Miky8745/HalfLife-Drone/frame/drone-framev1.FCStd

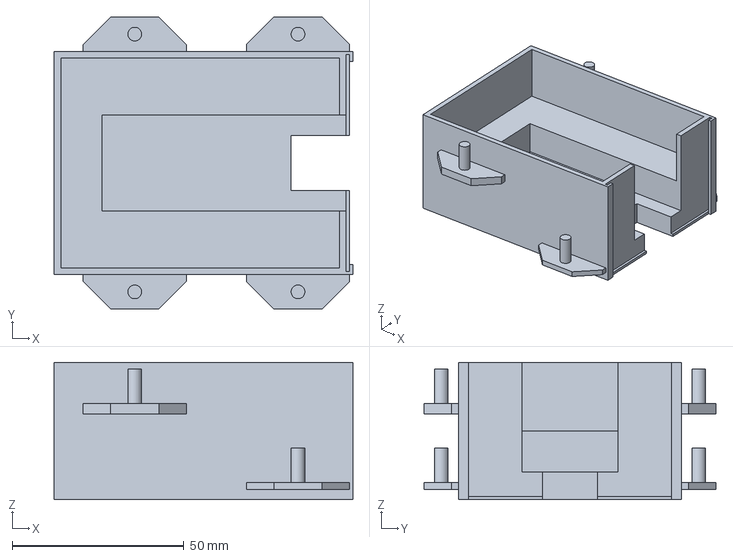
[picture p3: CAD file, 2026-10-18]
frame/drone-framev1.FCStd
87.0 x 85.0 x 40.0 mm
