Miky8745/HalfLife-Drone/frame/freecad_demo/part5.FCStd

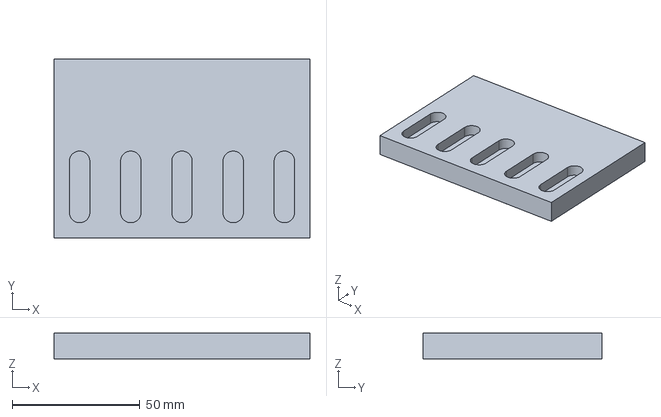
[picture p4: CAD file, 2026-10-12]
frame/freecad_demo/part5.FCStd
100.0 x 70.0 x 10.0 mm
