Miky8745/HalfLife-Drone/frame/step/drone-framev2.step

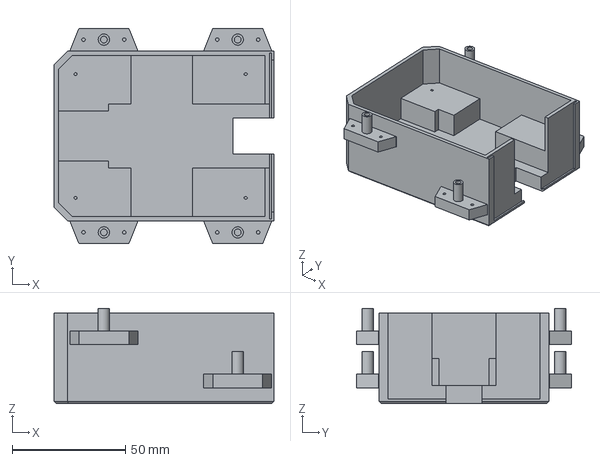
[picture p5: CAD file, 2026-11-12]
frame/step/drone-framev2.step
97.0 x 95.0 x 42.0 mm
