Miky8745/HalfLife-Drone/frame/freecad_demo/part7.FCStd

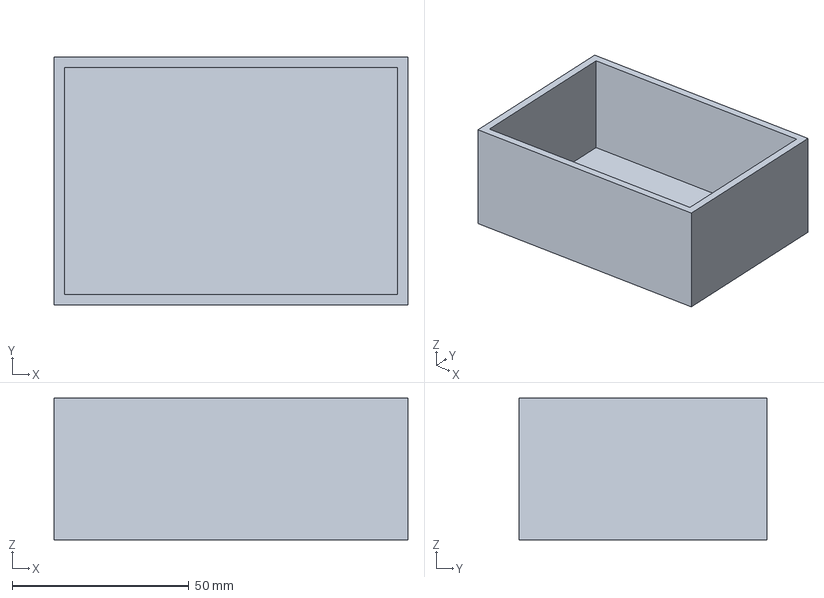
[picture p6: CAD file, 2026-10-12]
frame/freecad_demo/part7.FCStd
100.0 x 70.0 x 40.0 mm
