Miky8745/HalfLife-Drone/frame/step/backplate.step

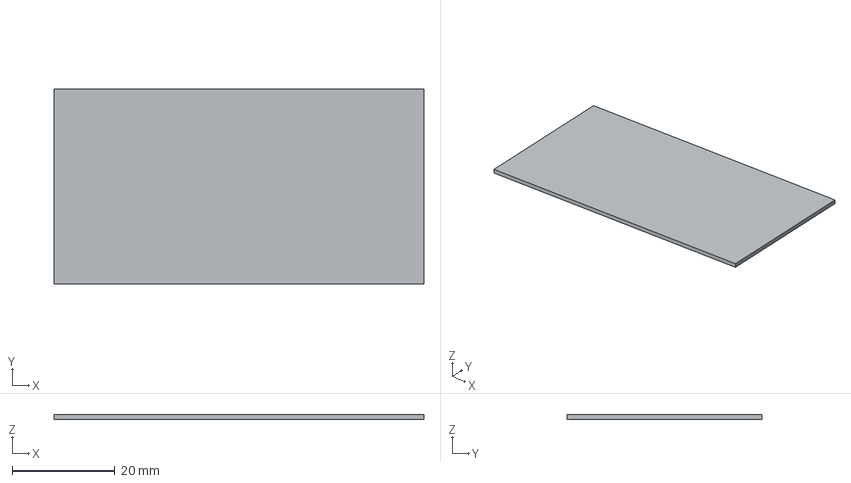
[picture p7: CAD file, 2026-11-12]
frame/step/backplate.step
72.0 x 38.0 x 1.00 mm
