Miky8745/HalfLife-Drone/frame/freecad_demo/part2.FCStd

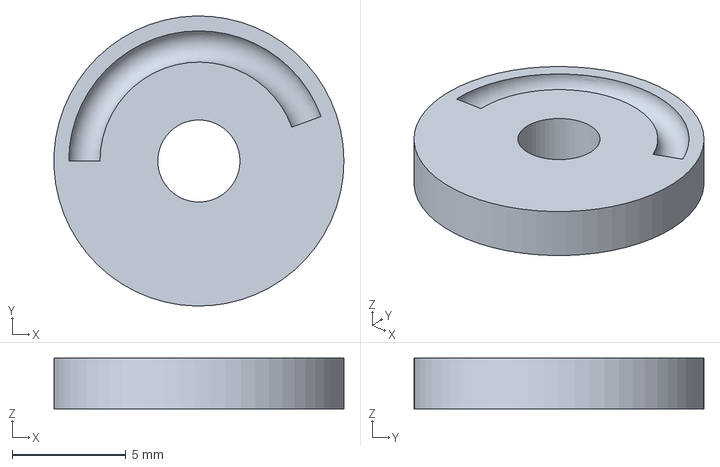
[picture p8: CAD file, 2026-10-12]
frame/freecad_demo/part2.FCStd
12.8 x 12.8 x 2.24 mm
