Miky8745/HalfLife-Drone/frame/step/prop_holder_a.step

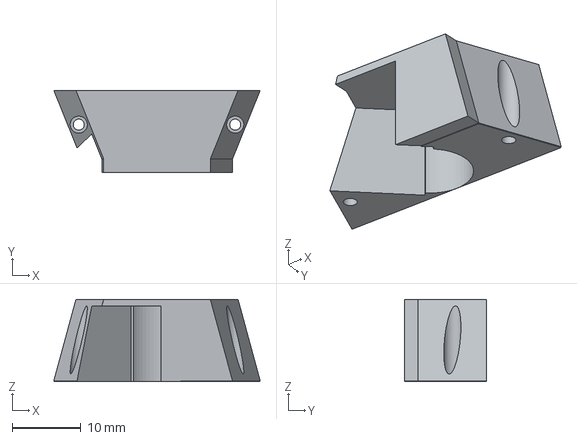
[picture p9: CAD file, 2026-11-12]
frame/step/prop_holder_a.step
30.0 x 12.0 x 12.0 mm
