Miky8745/HalfLife-Drone/frame/freecad_demo/part1.FCStd

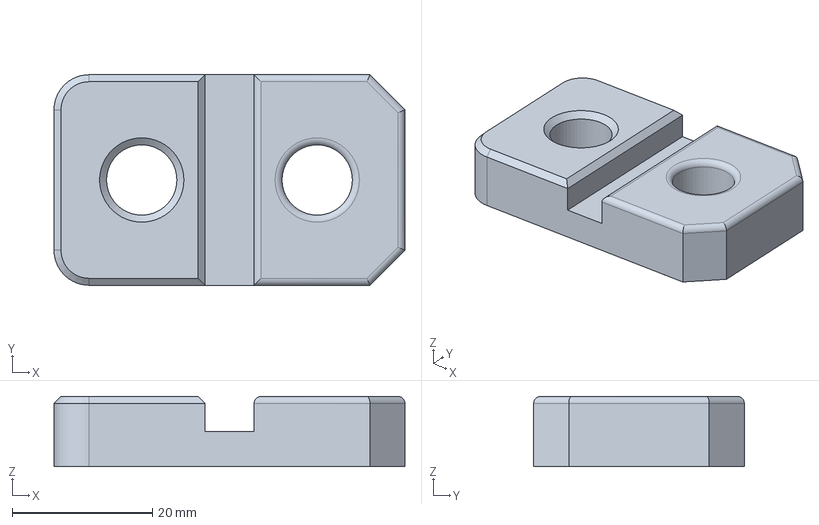
[picture p10: CAD file, 2026-10-12]
frame/freecad_demo/part1.FCStd
50.0 x 30.0 x 10.0 mm
