Miky8745/HalfLife-Drone/frame/step/roof.step

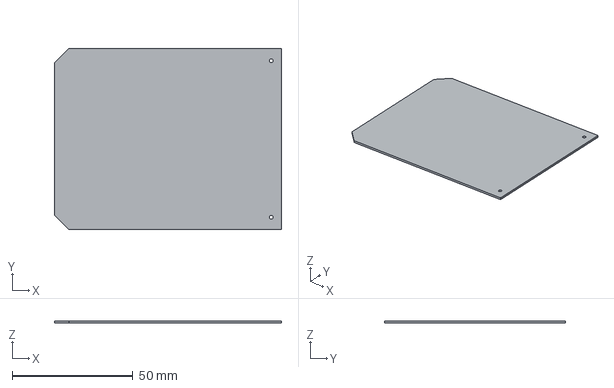
[picture p11: CAD file, 2026-11-12]
frame/step/roof.step
94.0 x 75.0 x 1.00 mm
