Miky8745/HalfLife-Drone/frame/freecad_demo/part6.FCStd

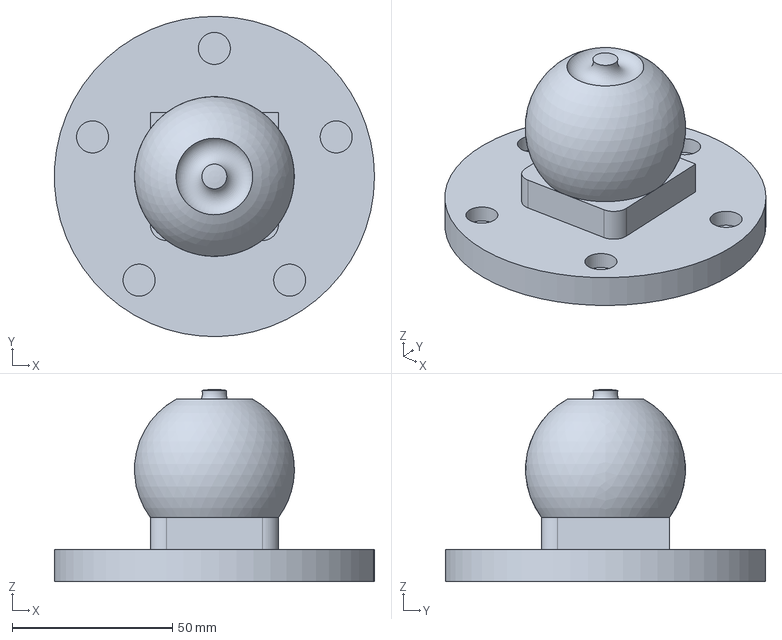
[picture p12: CAD file, 2026-10-12]
frame/freecad_demo/part6.FCStd
99.9 x 100.0 x 60.0 mm
