Miky8745/HalfLife-Drone/frame/freecad_demo/part3.FCStd

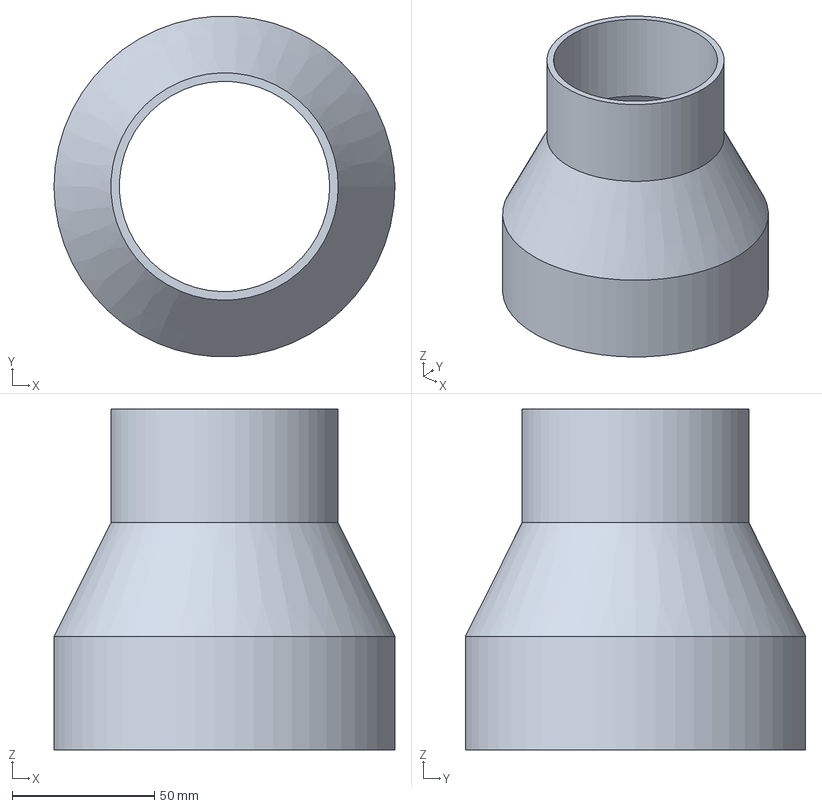
[picture p13: CAD file, 2026-10-12]
frame/freecad_demo/part3.FCStd
120.0 x 119.8 x 120.0 mm
