Miky8745/HalfLife-Drone/frame/step/pcb_holder.step

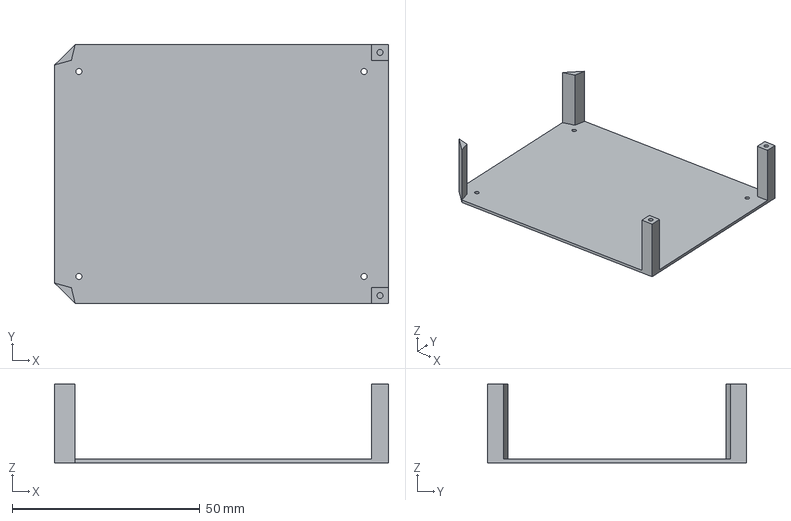
[picture p14: CAD file, 2026-11-12]
frame/step/pcb_holder.step
89.0 x 69.0 x 21.0 mm
