Miky8745/HalfLife-Drone/frame/freecad_demo/part4.FCStd

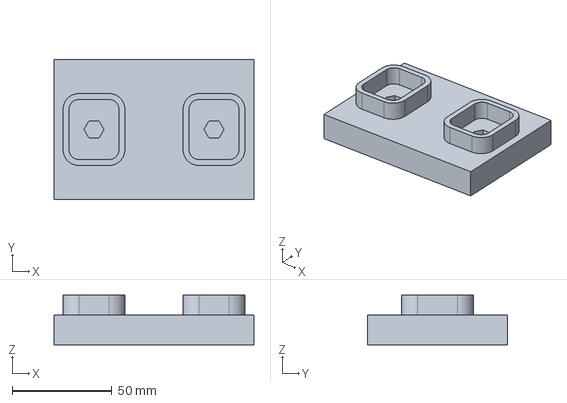
[picture p15: CAD file, 2026-10-12]
frame/freecad_demo/part4.FCStd
100.0 x 70.0 x 25.0 mm
