Miky8745/HalfLife-Drone/(list of files, cad)

Other CAD files:
frame/stl/drone-frame.stl
frame/step/prop_holder_b.step
frame/backplate.FCStd
frame/drone-framev2.FCStd
frame/pcb_holder.FCStd
frame/prop_holder_a.FCStd
frame/prop_holder_b.FCStd
frame/roof.FCStd
frame/stl/backplate.stl
frame/stl/pcb-holder.stl
frame/stl/prop_holder_a.stl
frame/stl/prop_holder_b.stl
frame/stl/roof.stl
