Miky8745/HalfLife-Drone/esp_extension/esp_extension.kicad_pcb

## KiCad design esp_extension/esp_extension.kicad_pcb (2026-10-11)

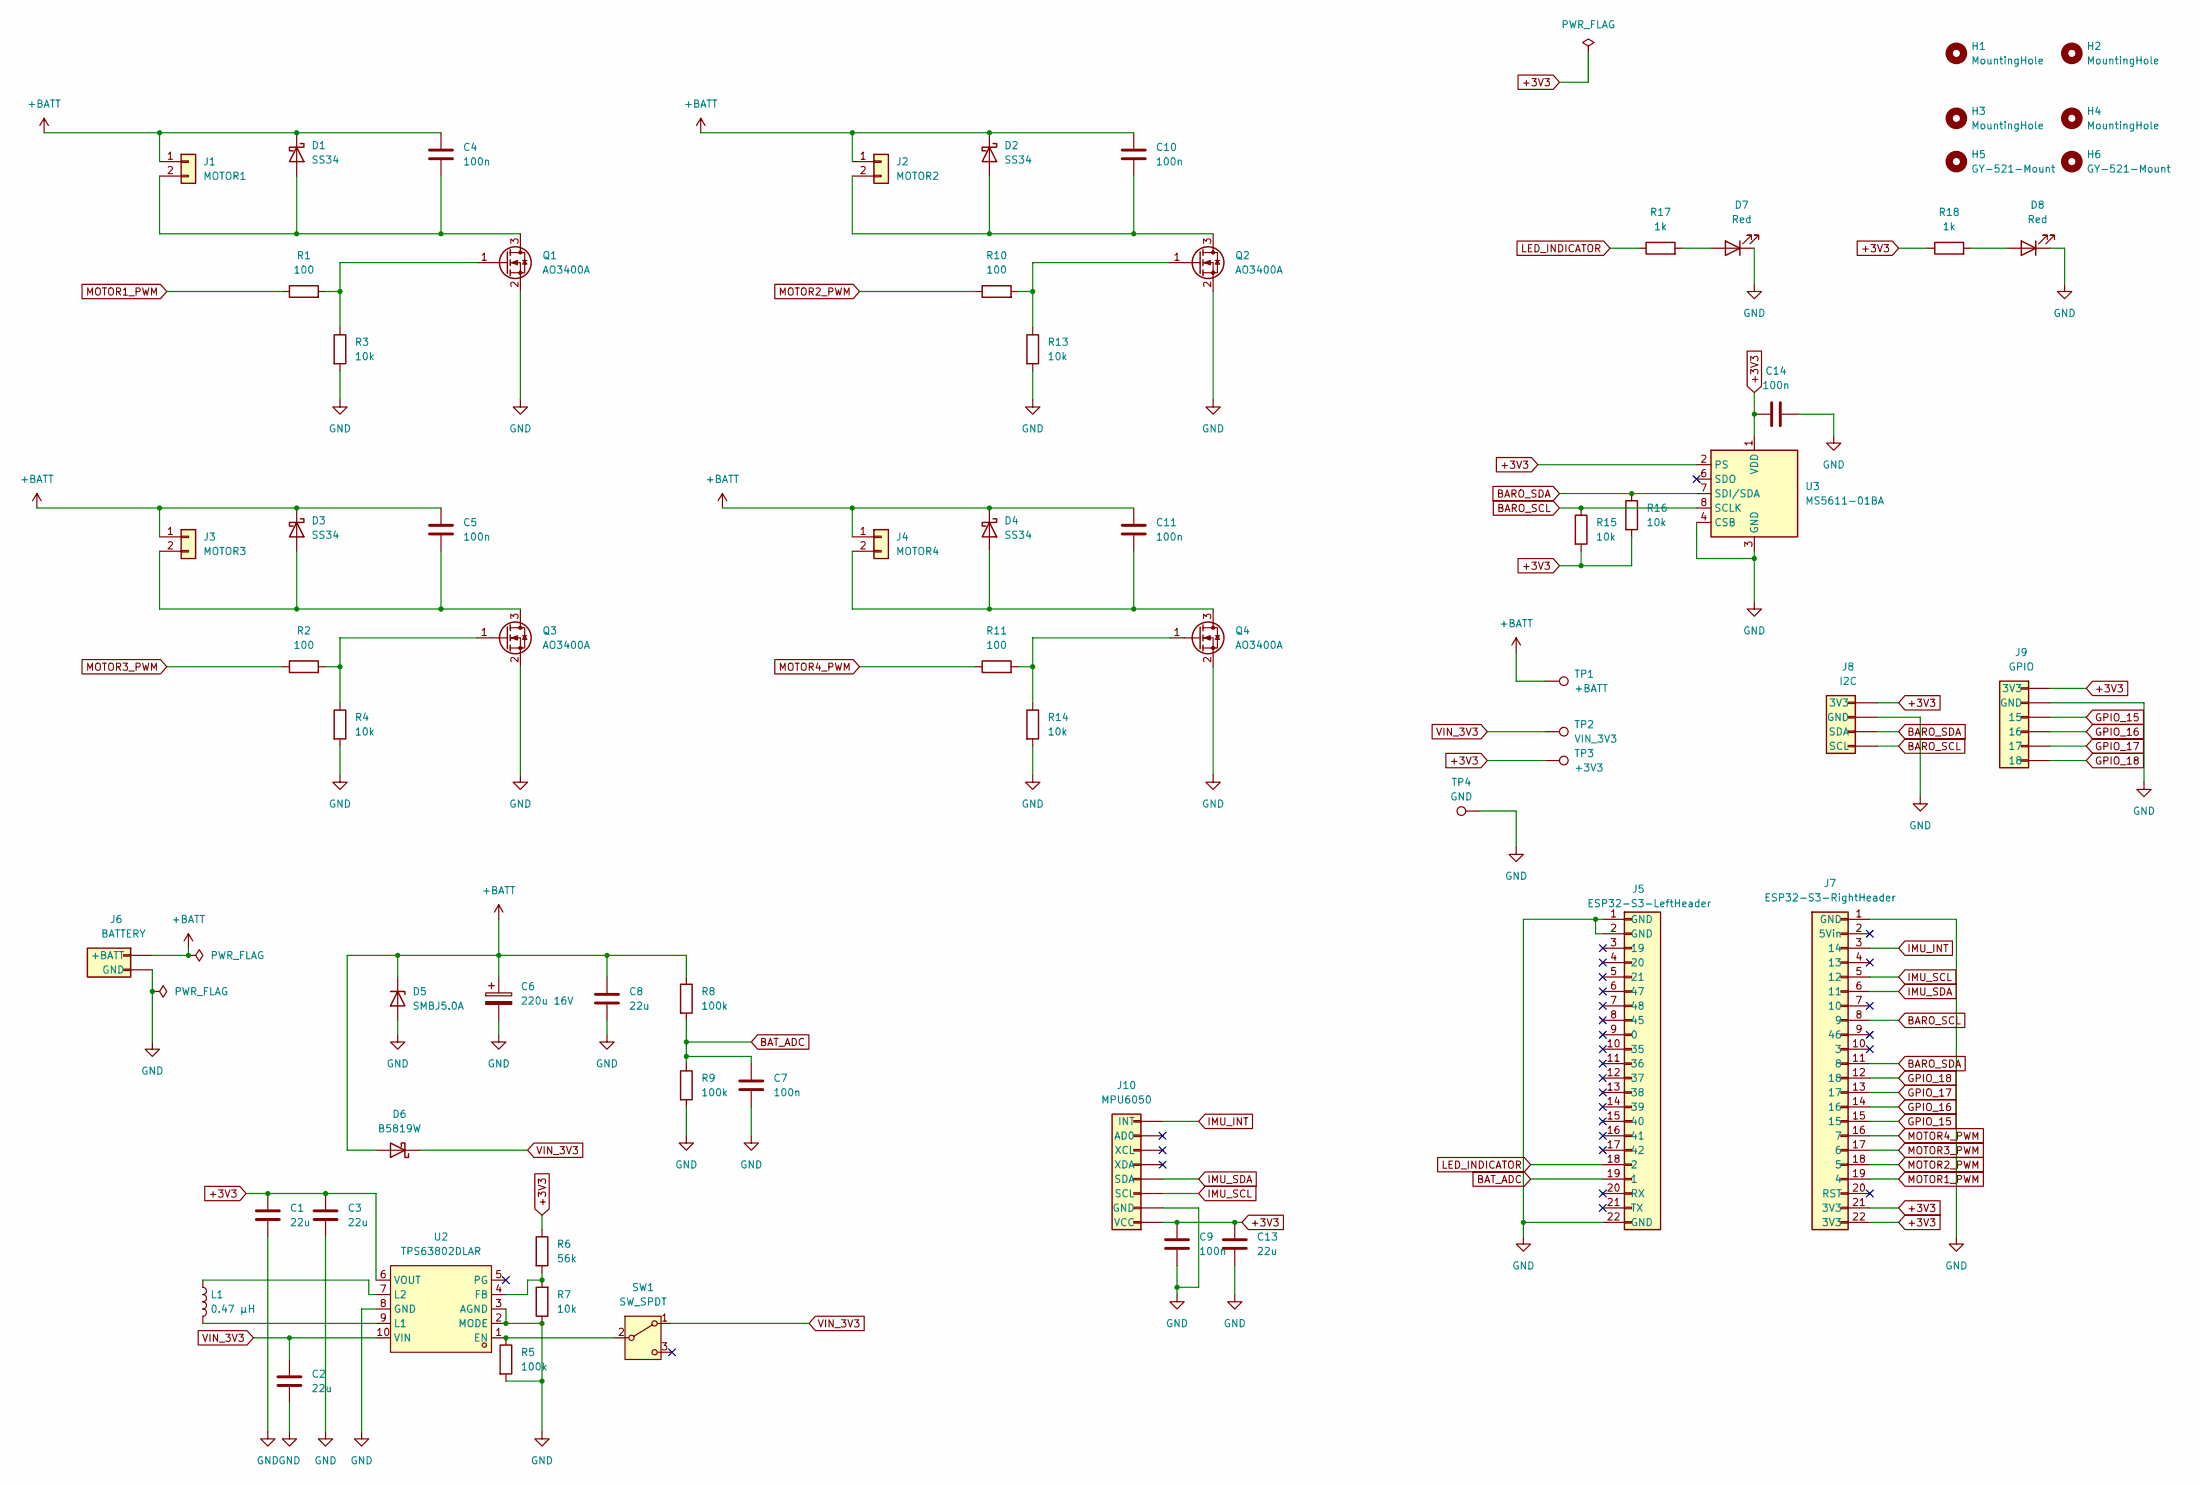
[picture p16: schematic esp_extension.kicad_sch, ESP32 Drone Motor Card]

Parts:
C1, C2, C3, C8, C13: 22u; C_0805_2012Metric; MPN CL21A226MAQNNNE; LCSC Part C45783
C4, C5, C7, C9, C10, C11, C14: 100n; C_0603_1608Metric; MPN CC0603KRX7R9BB104; LCSC Part C14663
C6: 220u 16V; CP_Radial_D6.3mm_P2.50mm; MPN TFR_220_16_85
D1, D2, D3, D4: SS34; D_SMA; MPN SS34; LCSC Part C8678
D5: SMBJ5.0A; D_SMB; MPN SMBJ5.0A; LCSC Part C19077558
D6: B5819W; D_SOD-123; MPN B5819W SL; LCSC Part C8598
D7, D8: Red; LED_0603_1608Metric; MPN KT-0603R; LCSC Part C2286
H1, H2, H3, H4: MountingHole; MountingHole_2.2mm_M2
H5, H6: GY-521-Mount; MountingHole_3.2mm_M3
J1: MOTOR1; SolderWire-0.25sqmm_1x02_P4.2mm_D0.65mm_OD1.7mm
J2: MOTOR2; SolderWire-0.25sqmm_1x02_P4.2mm_D0.65mm_OD1.7mm
J3: MOTOR3; SolderWire-0.25sqmm_1x02_P4.2mm_D0.65mm_OD1.7mm
J4: MOTOR4; SolderWire-0.25sqmm_1x02_P4.2mm_D0.65mm_OD1.7mm
J5: ESP32-S3-LeftHeader; PinSocket_1x22_P2.54mm_Vertical
J6: BATTERY; SolderWire-0.5sqmm_1x02_P4.8mm_D0.9mm_OD2.3mm
J7: ESP32-S3-RightHeader; PinSocket_1x22_P2.54mm_Vertical
J8: I2C; PinHeader_1x04_P2.54mm_Vertical
J9: GPIO; PinHeader_1x06_P2.54mm_Vertical
J10: MPU6050; PinSocket_1x08_P2.54mm_Vertical
L1: 0.47 µH; IND-SMD_L2.0-W1.6-1; MPN DFE201612E-R47M=P2; LCSC Part C668312
Q1, Q2, Q3, Q4: AO3400A; SOT-23; MPN AO3400A; LCSC Part C20917
R1, R2, R10, R11: 100; R_0603_1608Metric; MPN 0603WAF1000T5E; LCSC Part C22775
R3, R4, R7, R13, R14, R15, R16: 10k; R_0603_1608Metric; MPN 0603WAF1002T5E; LCSC Part C25804
R5, R8, R9: 100k; R_0603_1608Metric; MPN 0603WAF1003T5E; LCSC Part C25803
R6: 56k; R_0603_1608Metric; MPN 0603WAF5602T5E; LCSC Part C23206
R17, R18: 1k; R_0603_1608Metric; MPN 0603WAF1001T5E; LCSC Part C21190
SW1: SW_SPDT; PinHeader_1x03_P2.54mm_Vertical; MPN S103mini
TP1: +BATT; TestPoint_Pad_D1.5mm
TP2: VIN_3V3; TestPoint_Pad_D1.5mm
TP3: +3V3; TestPoint_Pad_D1.5mm
TP4: GND; TestPoint_Pad_D1.5mm
U2: TPS63802DLAR; VSON-10_L3.0-W2.0-P0.50-TL; MPN TPS63802DLAR; LCSC Part C2845237
U3: MS5611-01BA; LGA-8_3x5mm_P1.25mm; MPN MS561101BA03-50; LCSC Part C15639

Connections:
+3V3: C1.1, C3.1, C9.2, C13.1, C14.1, J7.21 (3V3), J7.22 (3V3), J8.1 (3V3), J9.1 (3V3), J10.1 (VCC), R6.1, R15.2, R16.2, R18.1, TP3.1 (1_1), U2.6 (VOUT), U3.1 (VDD), U3.2 (PS)
+BATT: C4.1, C5.1, C6.1, C8.1, C10.1, C11.1, D1.1 (K), D2.1 (K), D3.1 (K), D4.1 (K), D5.1 (K), D6.2 (A), J1.1, J2.1, J3.1, J4.1, J6.1 (+BATT), R8.1, TP1.1 (1_1)
BARO_SCL: J7.8 (9), J8.4 (SCL), R15.1, U3.8 (SCLK)
BARO_SDA: J7.11 (8), J8.3 (SDA), R16.1, U3.7 (SDI/SDA)
BAT_ADC: C7.1, J5.19 (1), R8.2, R9.1
GND: C1.2, C2.2, C3.2, C6.2, C7.2, C8.2, C9.1, C13.2, C14.2, D5.2 (A), D7.1 (K), D8.1 (K), J5.1 (GND), J5.2 (GND), J5.22 (GND), J6.2 (GND), J7.1 (GND), J8.2 (GND), J9.2 (GND), J10.2 (GND), Q1.2 (S), Q2.2 (S), Q3.2 (S), Q4.2 (S), R3.2, R4.2, R5.2, R7.1, R9.2, R13.2, R14.2, TP4.1 (1_1), U2.2 (MODE), U2.3 (AGND), U2.8 (GND), U3.3 (GND), U3.4 (CSB), U3.5 (CSB)
GPIO_15: J7.15, J9.3 (15)
GPIO_16: J7.14 (16), J9.4 (16)
GPIO_17: J7.13 (17), J9.5 (17)
GPIO_18: J7.12 (18), J9.6 (18)
IMU_INT: J7.3 (14), J10.8 (INT)
IMU_SCL: J7.5 (12), J10.3 (SCL)
IMU_SDA: J7.6 (11), J10.4 (SDA)
LED_INDICATOR: J5.18 (2), R17.1
MOTOR1_PWM: J7.19 (4), R1.1
MOTOR2_PWM: J7.18 (5), R10.1
MOTOR3_PWM: J7.17 (6), R2.1
MOTOR4_PWM: J7.16 (7), R11.1
unnamed: C4.2, D1.2 (A), J1.2, Q1.3 (D)
unnamed: C10.2, D2.2 (A), J2.2, Q2.3 (D)
unnamed: C5.2, D3.2 (A), J3.2, Q3.3 (D)
unnamed: C11.2, D4.2 (A), J4.2, Q4.3 (D)
unnamed: D7.2 (A), R17.2
unnamed: D8.2 (A), R18.2
unnamed: Q1.1 (G), R1.2, R3.1
unnamed: Q2.1 (G), R10.2, R13.1
unnamed: Q3.1 (G), R2.2, R4.1
unnamed: Q4.1 (G), R11.2, R14.1
unnamed: R5.1, SW1.2 (B), U2.1 (EN)
unnamed: R6.2, R7.2, U2.4 (FB)
unnamed: L1.2, U2.9 (L1)
unnamed: L1.1, U2.7 (L2)
VIN_3V3: C2.1, D6.1 (K), SW1.1 (A), TP2.1 (1_1), U2.10 (VIN)

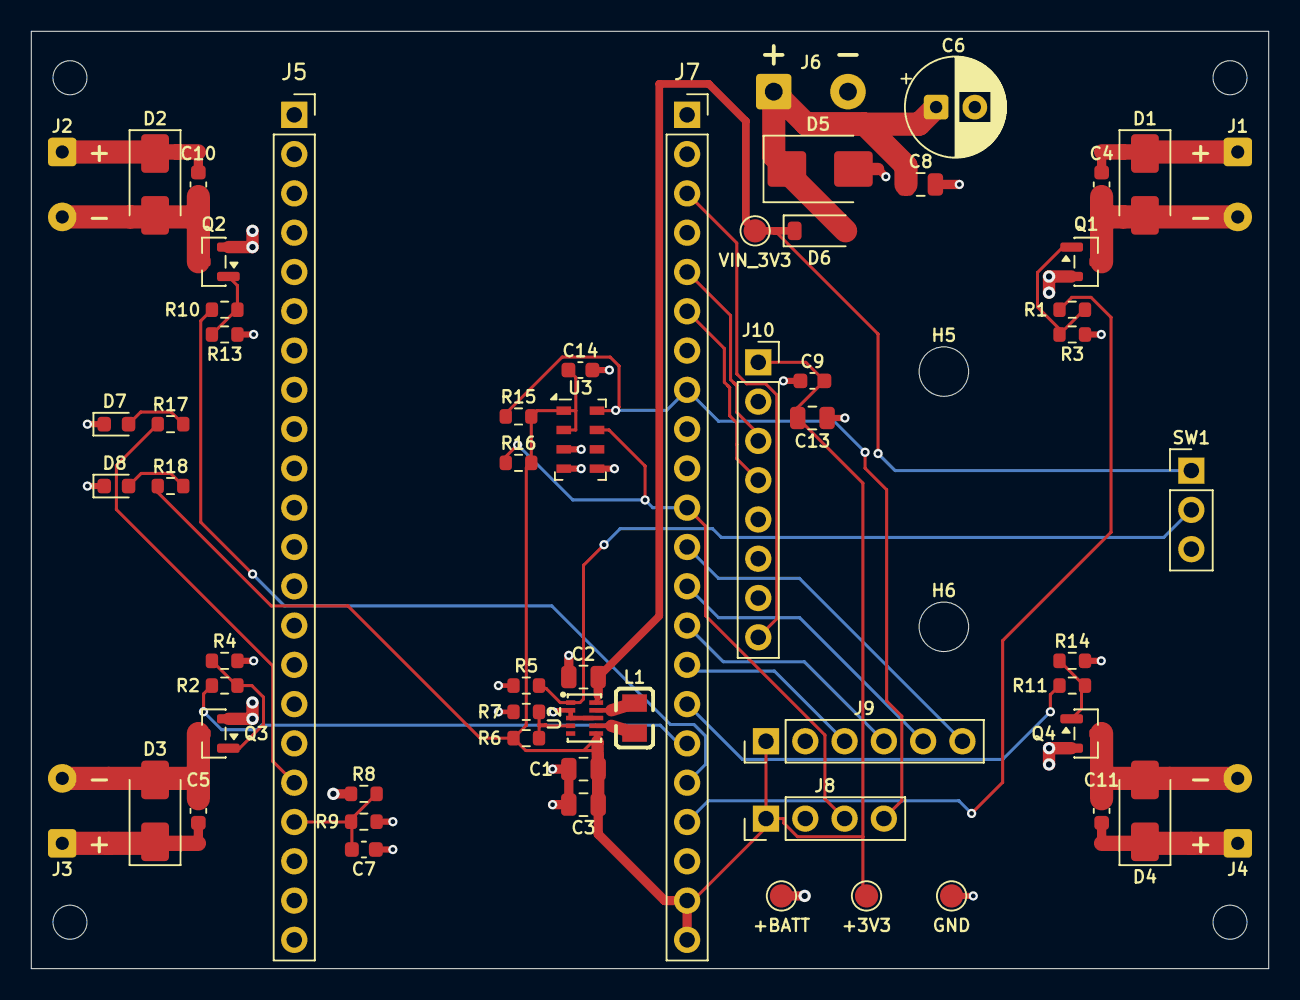
[picture p17: board esp_extension.kicad_pcb from above]

Board: 4 copper layers, 80.0 x 60.6 mm, 66 parts (0 on the bottom side), 33 nets.
