Miky8745/HalfLife-Drone/(commit log)

2026-10-11 Moved the motors to the left side as well
    [esp_extension.kicad_pcb]
2026-10-11 Board ready for tracing
    [esp_extension.kicad_pcb]
2026-10-11 Voltage regulator routed
    [esp_extension.kicad_pcb]
2026-10-11 Autorouted and checked the entire board
    [esp_extension.kicad_pcb]
2026-10-11 JLC production files
    [bom.csv, designators.csv, esp_extension.csv, esp_extension.kicad_pcb, esp_extension.kicad_sch, esp_extension_bom.csv, positions.csv]
2026-10-12 Started learning freecad for the frame
    [part1.FCStd, part2.FCStd, part3.FCStd, part4.FCStd, part5.FCStd, part6.FCStd, part7.FCStd]
2026-10-18 Finally remembered to commit freecad files to github
    [backplate.FCStd, backplate.stl, drone-frame.stl, drone-framev1.FCStd, drone-framev2.FCStd, pcb-holder.stl, pcb_holder.FCStd, prop_holder_a.FCStd]
2026-10-19 Add frame render and image to README
    Added a render of the frame and its image to the README.
2026-10-21 Added bom to readme
    [BOM.csv]
2026-11-12 Added step files
    [backplate.step, drone-framev2.step, pcb_holder.step, prop_holder_a.step, prop_holder_b.step, roof.step]
